justinselbo/EPICS-ISBVI-TUNER/(commit log)

2020-10-09 Put SPRING19 file in folder
2020-10-09 Add SPRING20 file
2020-10-16 Put SPRING20 file in folder
2020-10-23 Add initial moving average filter
2020-10-23 Remove extra closing bracket from filtering code
2020-10-30 Readd original SPRING20 and add both audio sets on FALL20
2020-11-06 Change kernel size from 5 to 3 and change serial printing
2020-11-06 Fix playback of exact tuning
    [FALL20.ino]
2020-11-20 Add filtering MATLAB code
2021-01-29 new file: Spring21/Spring21.ino
2021-04-30 modified: Spring21/Spring21.ino
